banjomasterpete/TeensyWind/TWind schematic.pdf

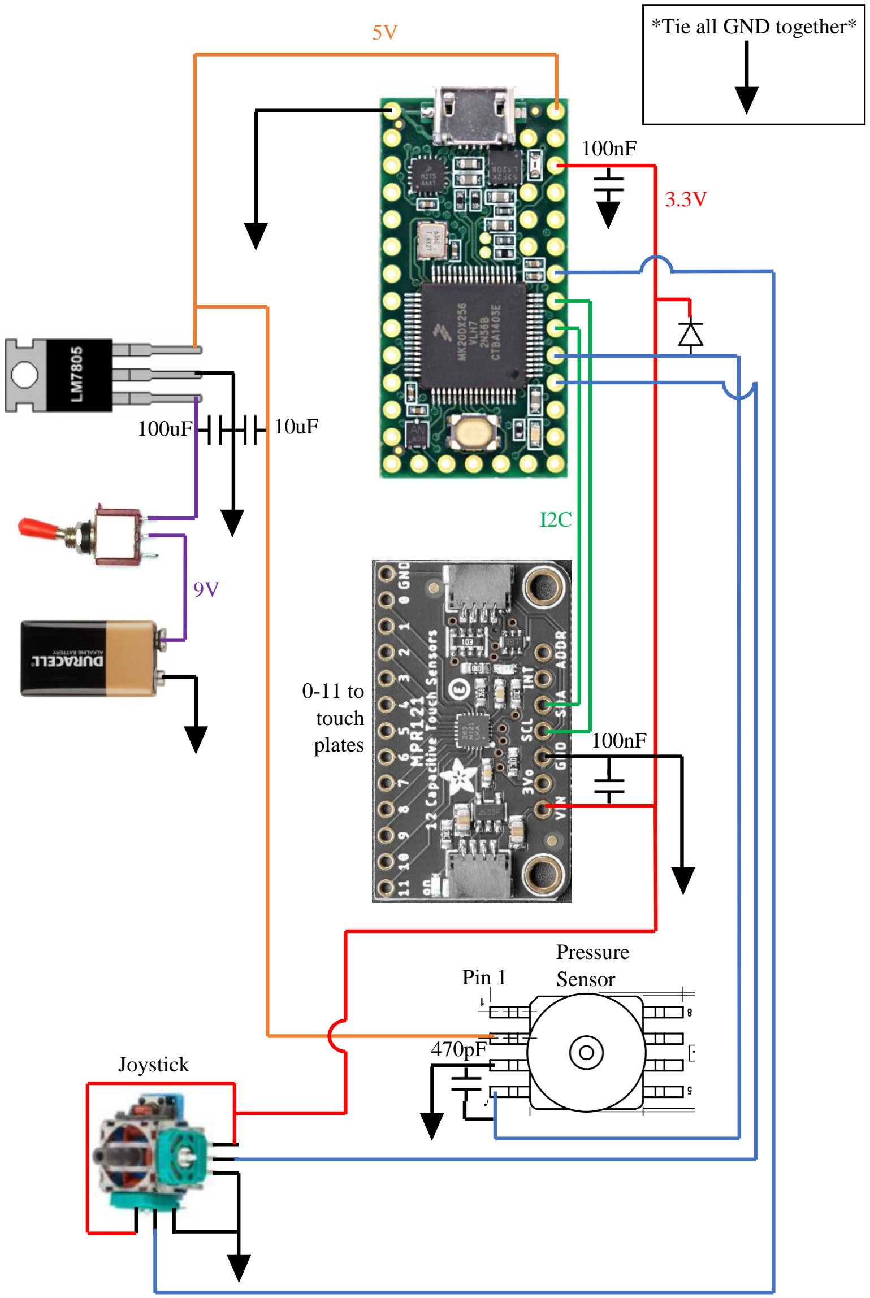
[picture p1: figure]
0-11 to touch plates; Pressure; Pin 1; Sensor; Joystick; *Tie all GND together*
