banjomasterpete/TeensyWind/TeensyWindBDV4 bc.png

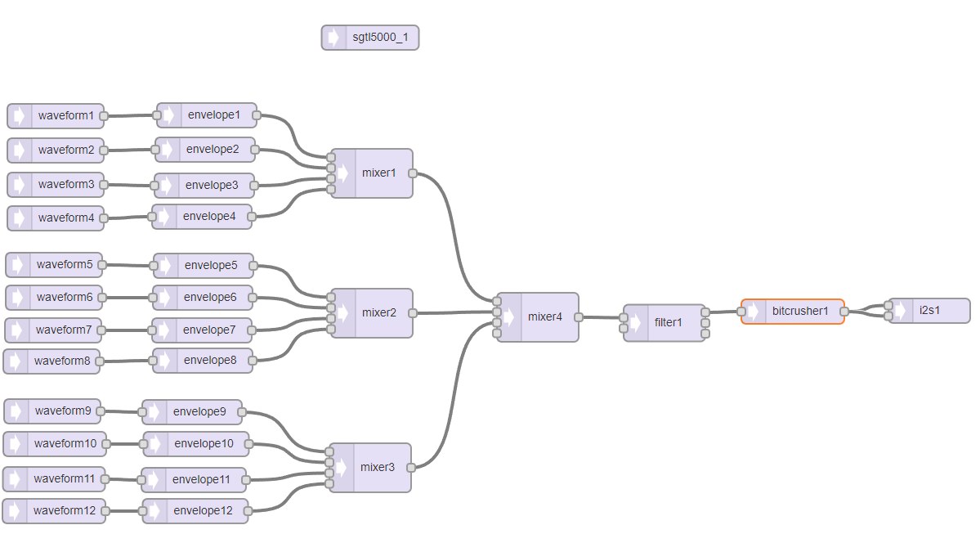
TeensyWindBDV4 bc.png
