banjomasterpete/TeensyWind/Mouthpiece.stl

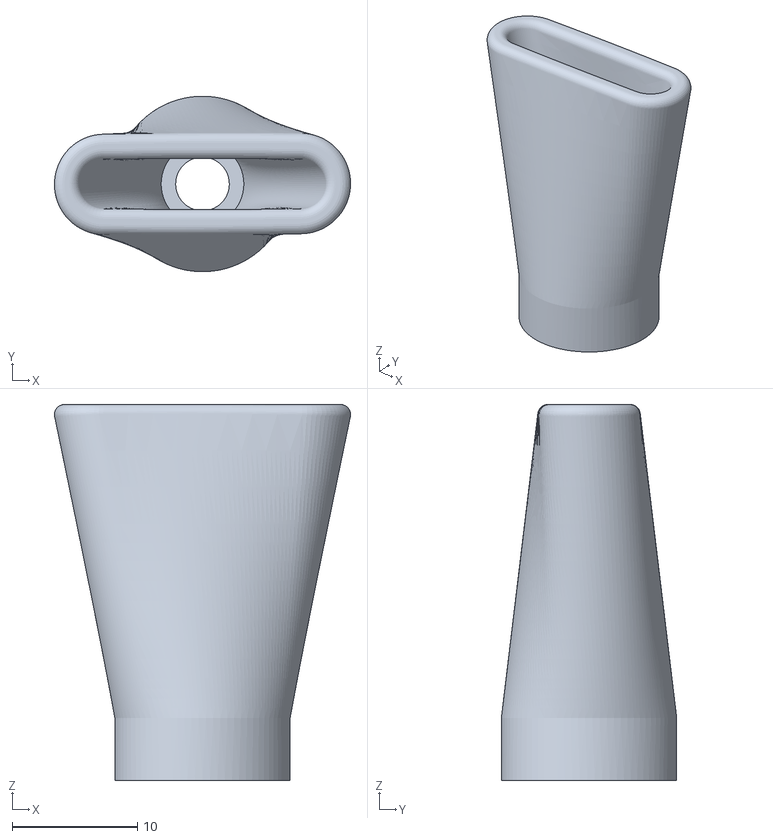
[picture p3: CAD file, 2022-02-06]
Mouthpiece.stl
23.6 x 14.0 x 30.0
