banjomasterpete/TeensyWind/TWindSides1.stl

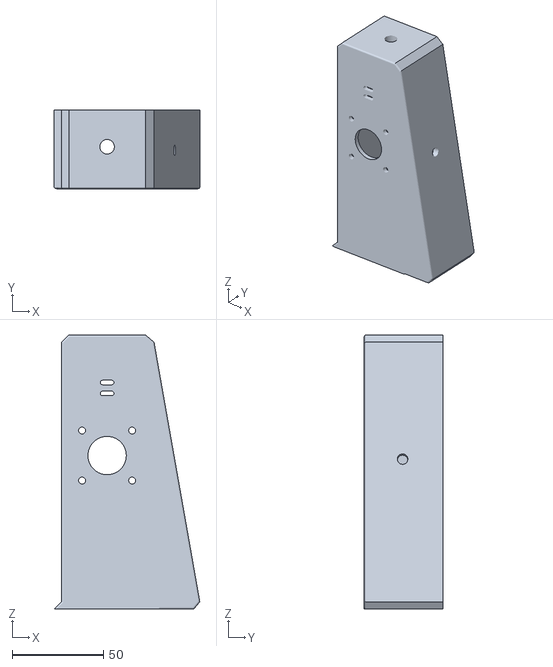
[picture p4: CAD file, 2022-02-06]
TWindSides1.stl
79.8 x 43.0 x 150.0
