banjomasterpete/TeensyWind/(list of files, cad)

Other CAD files:
TWindSides2.stl
