banjomasterpete/TeensyWind/TeensyWind Faceplate drill guide.pdf

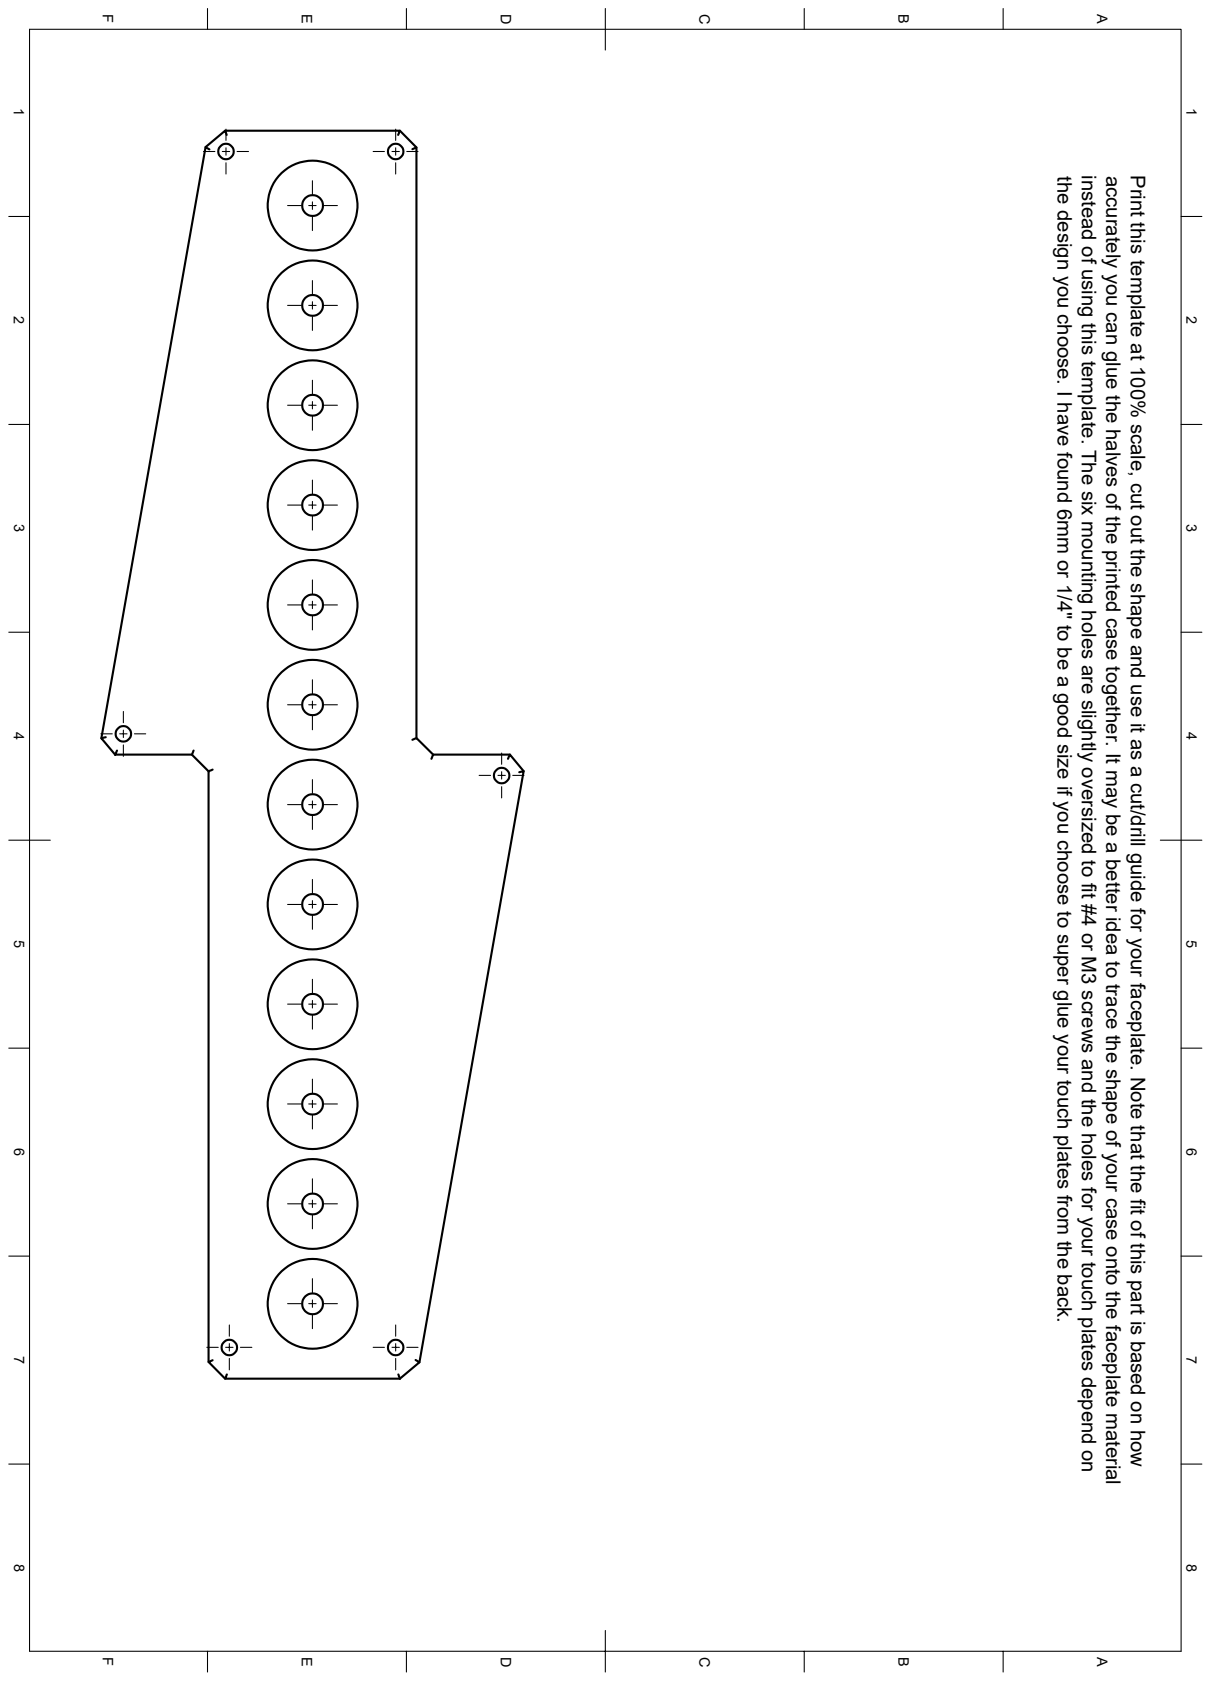
[picture p5: page 1]

1 A 2 3 4 5 6 7 8 1 2 3 4 5 6 7 8 FEDCB FEDCBA the design you choose. I have found 6mm or 1/4" to be a good size if you choose to super glue your touch plates from the back. instead of using this template. The six mounting holes are slightly oversized to fit #4 or M3 screws and the holes for your touch plates depend on accurately you can glue the halves of the printed case together. It may be a better idea to trace the shape of your case onto the faceplate material Print this template at 100% scale, cut out the shape and use it as a cut/drill guide for your faceplate. Note that the fit of this part is based on how
