banjomasterpete/TeensyWind/TeensyWind PCB drill guide.pdf

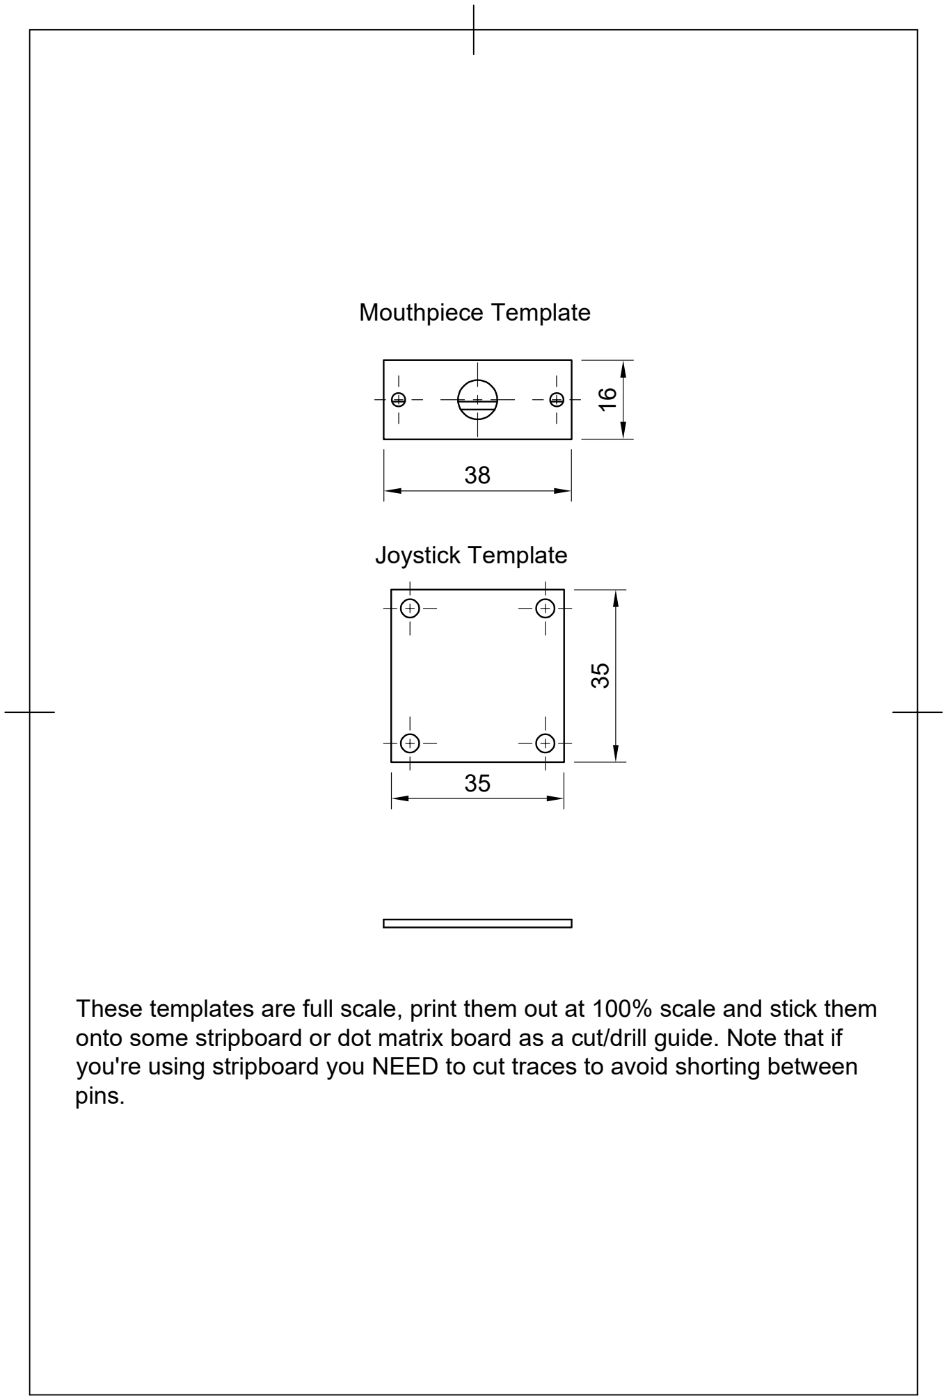
[picture p11: figure]
Mouthpiece Template; Joystick Template; pins.

These templates are full scale, print them out at 100% scale and stick them onto some stripboard or dot matrix board as a cut/drill guide. Note that if you're using stripboard you NEED to cut traces to avoid shorting between
